ice458/Continuity-checker/(notices)

Notices in the files:
README.md:
License:
[License: Apache 2.0](https://opensource.org/licenses/Apache-2.0)
